DD4WH/Teensy-DCF77/IMG_2182.JPG

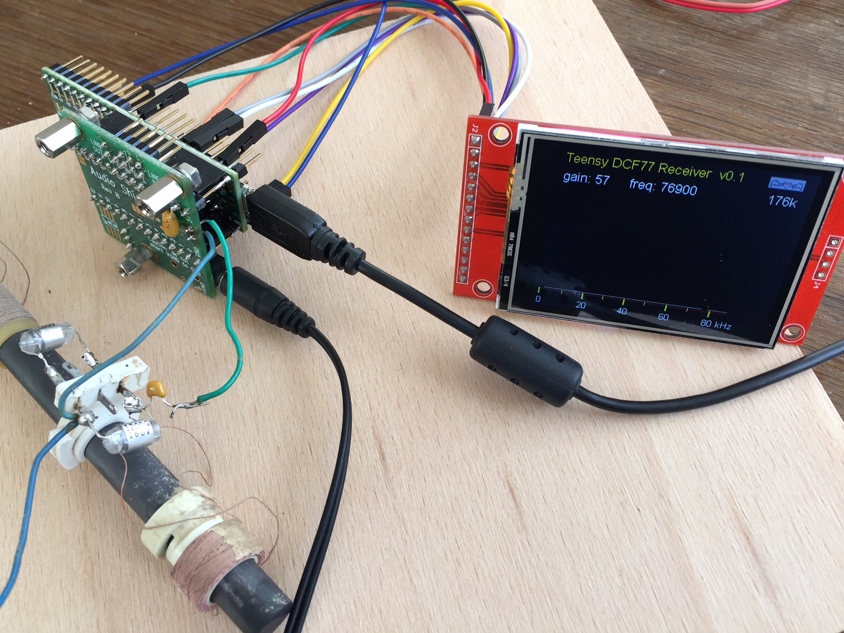
IMG_2182.JPG
