DD4WH/Teensy-DCF77/IMG_2188.JPG

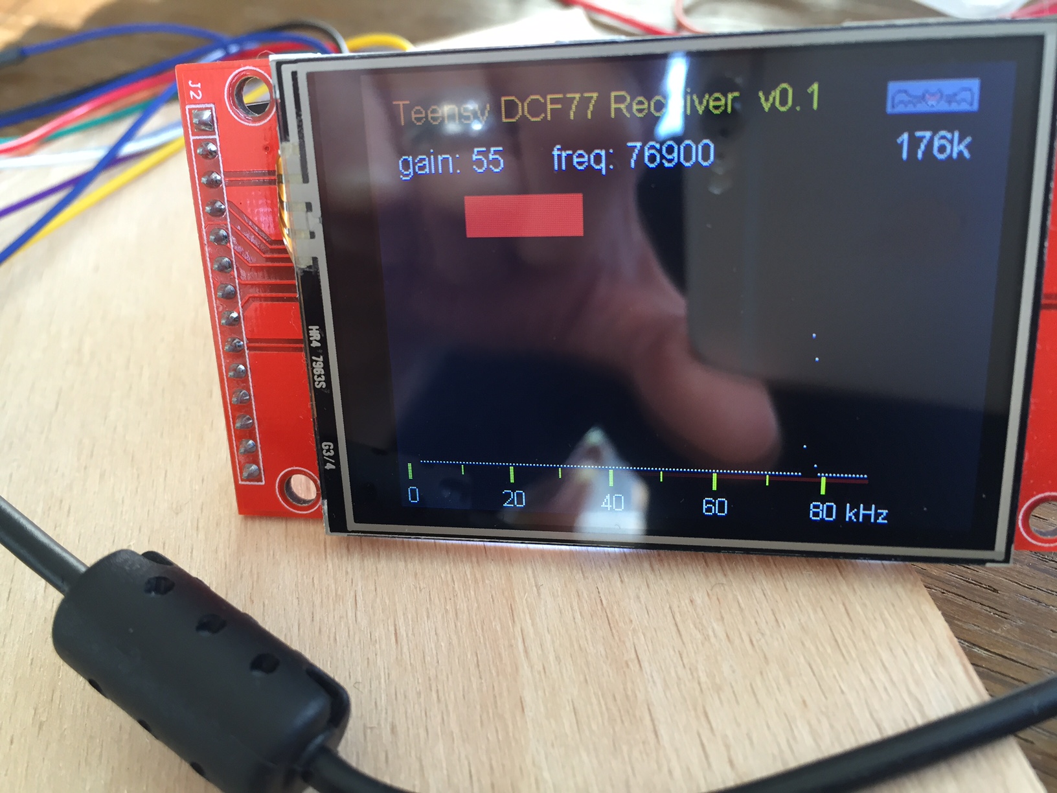
IMG_2188.JPG
