DD4WH/Teensy-DCF77/IMG_2197.JPG

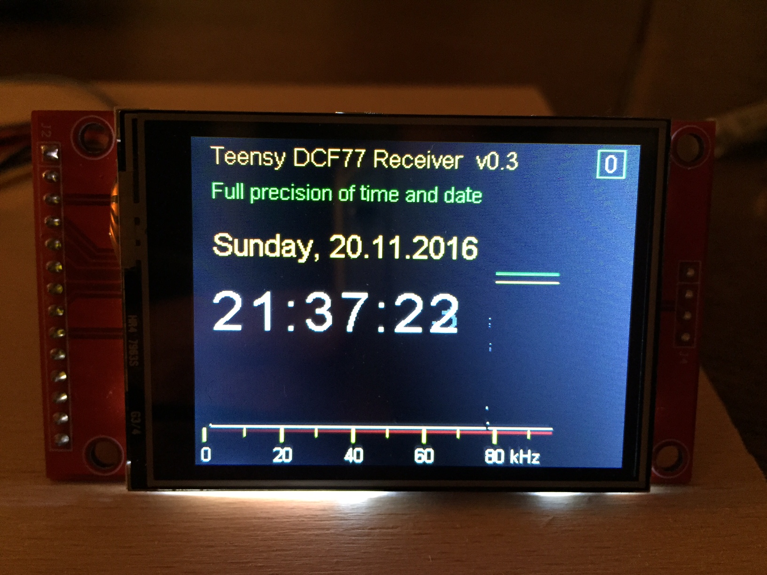
IMG_2197.JPG
