DD4WH/Teensy-DCF77/Teensy_time_signal_external_hardware.JPG

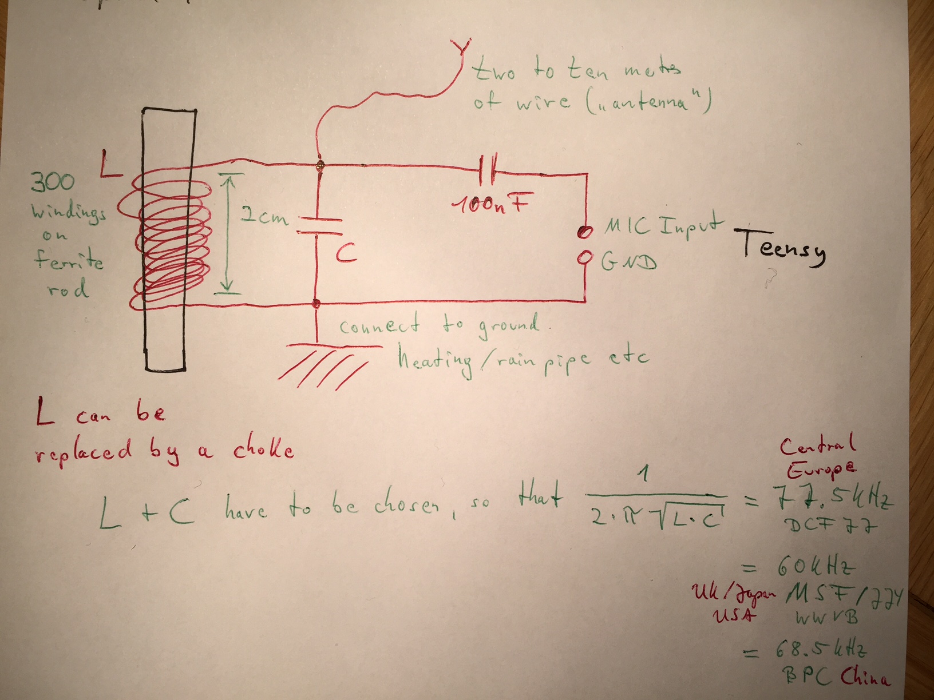
Teensy_time_signal_external_hardware.JPG
